RU09342-F18/intro-to-embedded-final-project-auditory-wombulations/(list of files, drawings)

Other design files:
5th_take_smallification_traces_finalized.dip
fundamental filter 27-110hz.dch
